mhbvr/flyback_converter_tests/board_0.2/sim/img/measured.png

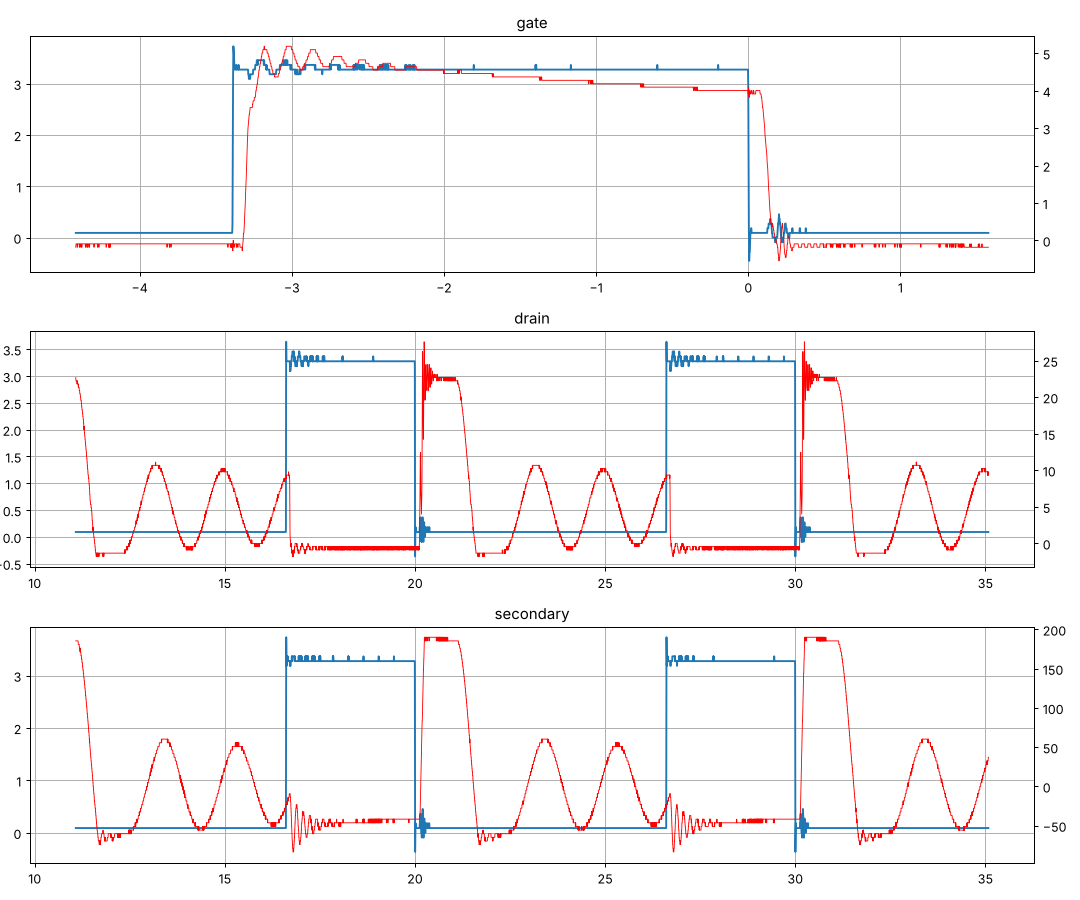
board_0.2/sim/img/measured.png
