mhbvr/flyback_converter_tests/(commit log)

2026-11-03 First experiment with perfboard
    [pwm-drain.csv, pwm-gate.csv, pwm-secondary.csv]
2026-11-03 Board 0.2: waveform analysis and ngspice simulation with vendor models
    Adds ANALYSIS.md with measured-vs-simulated comparison, loss budget and
    what-if runs, plus the ngspice setup (TI CSD18533KCS model fetch/patch
    script, DA2033/QH05TZ600/MCP1407 datasheet-based models, post-processing
    and plots).
    Claude-Session: https://claude.ai/code/session_01MDSEDz3TcHCjEyifGiqAfS
2026-11-03 Board 0.2 sim: tooling for MOSFET/diode candidate comparison
    Generic TI model patcher (unique helper-subckt names so several TI
    models can be loaded together), downloads for CSD18534KCS, CSD18543Q3A
    and Vishay BYG20J, ideal-device bounding models, datasheet-fitted
    600 V/1 A ultrafast diode model, device-swap hooks in runcase.sh.
    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
2026-11-03 Board 0.2 sim: equal-output-power candidate runs
    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
2026-11-03 Board 0.2: MOSFET/diode candidate comparison results
    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
2026-11-03 Board 0.2: cheaper MOSFET/diode options (generic-MOSFET sweep, CSD18541F5)
    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
2026-11-03 Board 0.2: compare with hackaday 170 V flybacks, load sweep of the ~90 % recipe
    Load resistor, input capacitor and primary-loop wiring become netlist
    parameters; hackaday.sh simulates board 0.2 as built vs. ceramic input
    caps + PCB-like loop + better devices at 5/9/12 V and 5-25 mA.
    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
